shulanx1/dynamic_clamp/README.md

# README #

### Dynamic clamp PCB board and code ###

* Dynamic clamp circuit adapted from Desai NS, Gray R, Johnston D. A Dynamic Clamp on Every Rig. eNeuro. 2017 Oct 23;4(5):ENEURO.0250-17.2017. doi: 10.1523/ENEURO.0250-17.2017. PMID: 29085905; PMCID: PMC5659377.

### Hardware ###

* microcontroller: teensy 3.6

### Files ###

* //dynamic clamp_V1&V2: PCB designs
* //dynamic clamp_V3: PCB design for two channel dynamic clamp
* //dynamic_clamp: arduino code to upload on the microcontroller
* //processing_contrl: GUI based on processing to set parameters on the fly
* //matlab_control: matlab script to sweep the conductance for high conductance state recordings

### Contact ###

* For any questions, contact kjayant@purdue.edu.
