shulanx1/dynamic_clamp/dynamic clamp_pcb - V3/dynamic clamp pcb.sch

## KiCad design dynamic clamp_pcb - V3/dynamic clamp pcb.sch (2023-08-11)

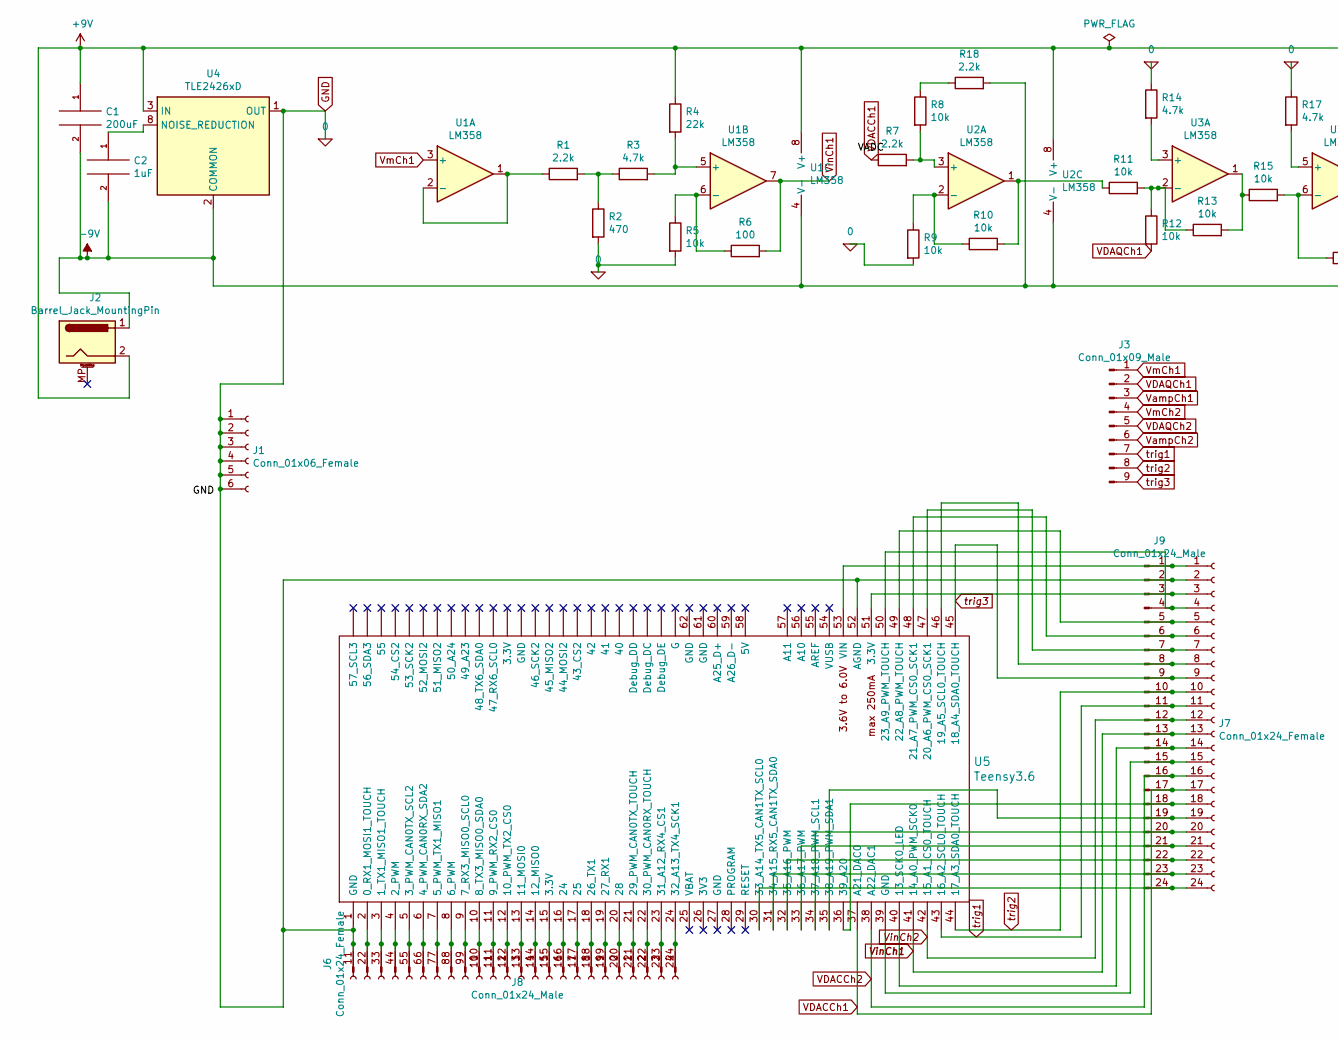
[picture p1: schematic dynamic clamp pcb.sch, part in row 1, column 1]

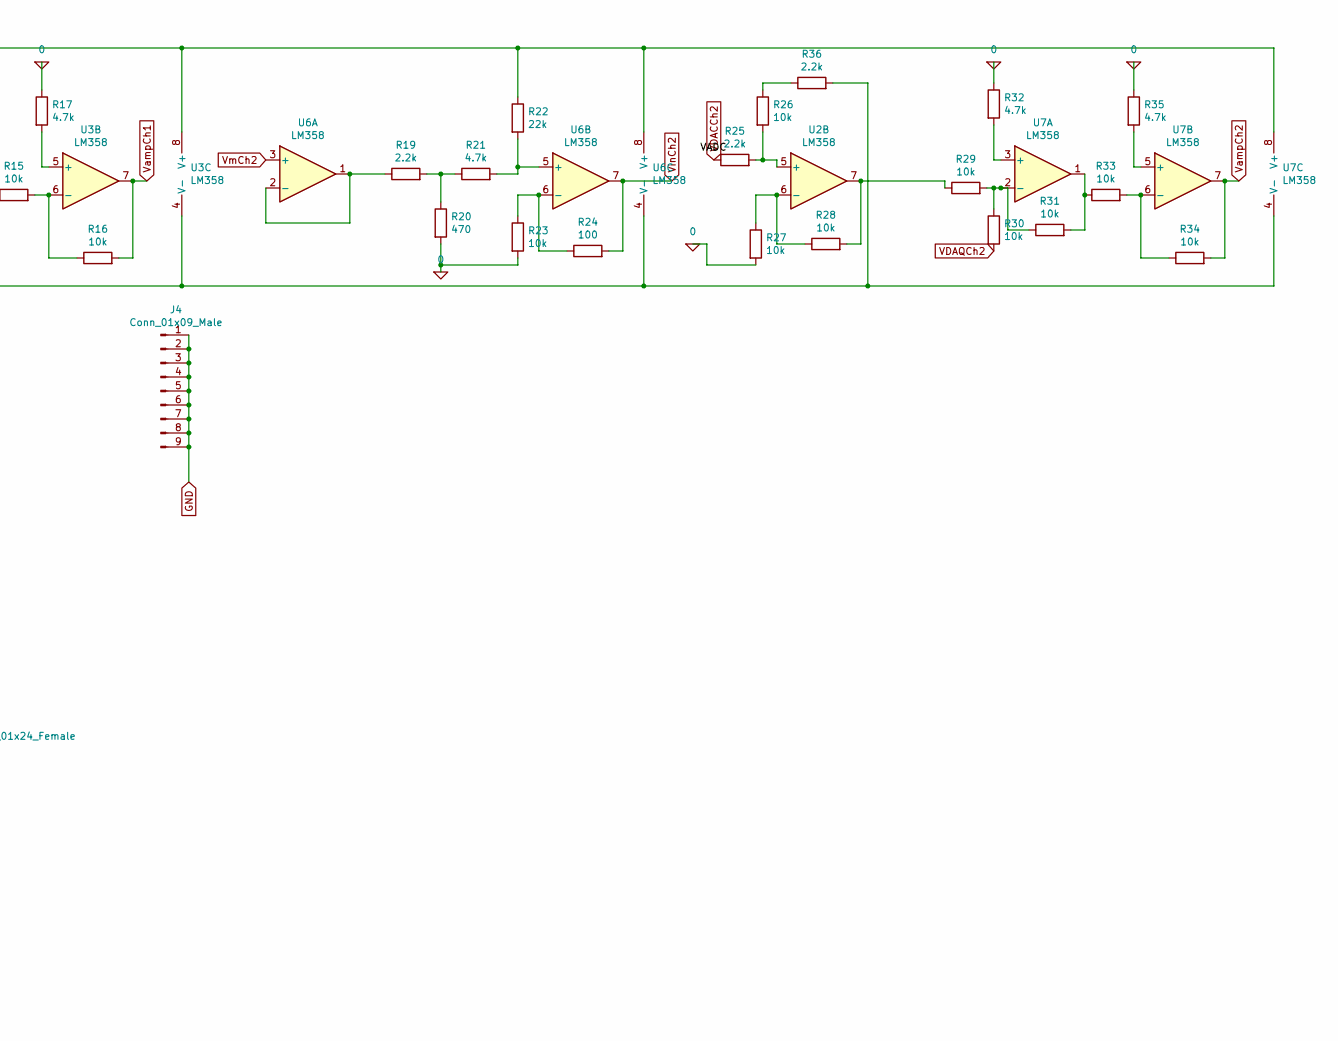
[picture p2: schematic dynamic clamp pcb.sch, part in row 1, column 2]

Parts:
C1: 200uF; CP_Radial_D12.5mm_P5.00mm
C2: 1uF; CP_Radial_D4.0mm_P1.50mm
J1: Conn_01x06_Female; PinHeader_1x06_P2.54mm_Vertical
J2: Barrel_Jack_MountingPin; BarrelJack_CUI_PJ-102AH_Horizontal
J3, J4: Conn_01x09_Male; PinHeader_1x09_P2.54mm_Vertical
J6, J7: Conn_01x24_Female; PinSocket_1x24_P2.54mm_Vertical
J8, J9: Conn_01x24_Male; PinHeader_1x24_P2.54mm_Vertical
R1, R7, R18, R19, R25, R36: 2.2k; R_Axial_DIN0207_L6.3mm_D2.5mm_P7.62mm_Horizontal
R2, R20: 470; R_Axial_DIN0207_L6.3mm_D2.5mm_P7.62mm_Horizontal
R3, R14, R17, R21, R32, R35: 4.7k; R_Axial_DIN0207_L6.3mm_D2.5mm_P7.62mm_Horizontal
R4, R22: 22k; R_Axial_DIN0207_L6.3mm_D2.5mm_P7.62mm_Horizontal
R5, R8, R9, R10, R11, R12, R13, R15, R16, R23, R26, R27, R28, R29, R30, R31, R33, R34: 10k; R_Axial_DIN0207_L6.3mm_D2.5mm_P7.62mm_Horizontal
R6, R24: 100; R_Axial_DIN0207_L6.3mm_D2.5mm_P7.62mm_Horizontal
U1, U2, U3, U6, U7: LM358; DIP-8_W7.62mm
U4: TLE2426xD; DIP-8_W7.62mm
U5: Teensy3.6; Teensy35_36

Connections:
0: J1.1, J1.2, J1.3, J1.4, J1.5, J1.6, J4.1, J4.2, J4.3, J4.4, J4.5, J4.6, J4.7, J4.8, J4.9, J6.1, J7.2, J8.1, J9.2, R2.2, R5.2, R9.2, R14.1, R17.1, R20.2, R23.2, R27.2, R32.1, R35.1, U4.1 (OUT), U5.1 (GND), U5.52 (AGND)
+9V: C1.1, J2.2, R4.1, R22.1, U1.8 (V+), U2.8 (V+), U3.8 (V+), U4.3 (IN), U6.8 (V+), U7.8 (V+)
-9V: C1.2, C2.2, J2.1, R18.2, R36.2, U1.4 (V-), U2.4 (V-), U3.4 (V-), U4.2 (COMMON), U6.4 (V-), U7.4 (V-)
unnamed: C2.1, U4.8 (NOISE_REDUCTION)
unnamed: J6.2, J8.2, U5.2 (0_RX1_MOSI1_TOUCH)
unnamed: J6.3, J8.3, U5.3 (1_TX1_MISO1_TOUCH)
unnamed: J6.4, J8.4, U5.4 (2_PWM)
unnamed: J6.5, J8.5, U5.5 (3_PWM_CAN0TX_SCL2)
unnamed: J6.6, J8.6, U5.6 (4_PWM_CAN0RX_SDA2)
unnamed: J6.7, J8.7, U5.7 (5_PWM_TX1_MISO1)
unnamed: J6.8, J8.8, U5.8 (6_PWM)
unnamed: J6.9, J8.9, U5.9 (7_RX3_MISO0_SCL0)
unnamed: J6.10, J8.10, U5.10 (8_TX3_MISO0_SDA0)
unnamed: J6.11, J8.11, U5.11 (9_PWM_RX2_CS0)
unnamed: J6.12, J8.12, U5.12 (10_PWM_TX2_CS0)
unnamed: J6.13, J8.13, U5.13 (11_MOSI0)
unnamed: J6.14, J8.14, U5.14 (12_MISO0)
unnamed: J6.15, J8.15, U5.15 (3.3V)
unnamed: J6.16, J8.16, U5.16 (24)
unnamed: J6.17, J8.17, U5.17 (25)
unnamed: J6.18, J8.18, U5.18 (26_TX1)
unnamed: J6.19, J8.19, U5.19 (27_RX1)
unnamed: J6.20, J8.20, U5.20 (28)
unnamed: J6.21, J8.21, U5.21 (29_PWM_CAN0TX_TOUCH)
unnamed: J6.22, J8.22, U5.22 (30_PWM_CAN0RX_TOUCH)
unnamed: J6.23, J8.23, U5.23 (31_A12_RX4_CS1)
unnamed: J6.24, J8.24, U5.24 (32_A13_TX4_SCK1)
unnamed: J7.1, J9.1, U5.53 (VIN)
unnamed: J7.3, J9.3, U5.51 (3.3V)
unnamed: J7.4, J9.4, U5.50 (23_A9_PWM_TOUCH)
unnamed: J7.5, J9.5, U5.49 (22_A8_PWM_TOUCH)
unnamed: J7.6, J9.6, U5.48 (21_A7_PWM_CS0_SCK1)
unnamed: J7.7, J9.7, U5.47 (20_A6_PWM_CS0_SCK1)
unnamed: J7.8, J9.8, U5.46 (19_A5_SCL0_TOUCH)
unnamed: J7.14, J9.14, U5.40 (13_SCK0_LED)
unnamed: J7.15, J9.15, U5.39 (GND)
unnamed: J7.18, J9.18, U5.36 (39_A20)
unnamed: J7.19, J9.19, U5.35 (38_A19_PWM_SDA1)
unnamed: J7.20, J9.20, U5.34 (37_A18_PWM_SCL1)
unnamed: J7.21, J9.21, U5.33 (36_A17_PWM)
unnamed: J7.22, J9.22, U5.32 (35_A16_PWM)
unnamed: J7.23, J9.23, U5.31 (34_A15_RX5_CAN1TX_SDA0)
unnamed: J7.24, J9.24, U5.30 (33_A14_TX5_CAN1TX_SCL0)
unnamed: R1.1, U1.1, U1.2 (-)
unnamed: R1.2, R2.1, R3.1
unnamed: R3.2, R4.2, U1.5 (+)
unnamed: R5.1, R6.1, U1.6 (-)
unnamed: R7.2, R8.2, U2.3 (+)
unnamed: R9.1, R10.1, U2.2 (-)
unnamed: R10.2, R11.1, U2.1
unnamed: R11.2, R12.1, R13.1, U3.2 (-)
unnamed: R13.2, R15.1, U3.1
unnamed: R14.2, U3.3 (+)
unnamed: R15.2, R16.1, U3.6 (-)
unnamed: R17.2, U3.5 (+)
unnamed: R8.1, R18.1
unnamed: R19.1, U6.1, U6.2 (-)
unnamed: R19.2, R20.1, R21.1
unnamed: R21.2, R22.2, U6.5 (+)
unnamed: R23.1, R24.1, U6.6 (-)
unnamed: R25.2, R26.2, U2.5 (+)
unnamed: R26.1, R36.1
unnamed: R27.1, R28.1, U2.6 (-)
unnamed: R28.2, R29.1, U2.7
unnamed: R29.2, R30.1, R31.1, U7.2 (-)
unnamed: R31.2, R33.1, U7.1
unnamed: R32.2, U7.3 (+)
unnamed: R33.2, R34.1, U7.6 (-)
unnamed: R35.2, U7.5 (+)
VDACCh1: J7.17, J9.17, R7.1, U5.37 (A21_DAC0)
VDACCh2: J7.16, J9.16, R25.1, U5.38 (A22_DAC1)
VDAQCh1: J3.2, R12.2
VDAQCh2: J3.5, R30.2
VampCh1: J3.3, R16.2, U3.7
VampCh2: J3.6, R34.2, U7.7
VinCh1: J7.13, J9.13, R6.2, U1.7, U5.41 (14_A0_PWM_SCK0)
VinCh2: J7.12, J9.12, R24.2, U5.42 (15_A1_CS0_TOUCH), U6.7
VmCh1: J3.1, U1.3 (+)
VmCh2: J3.4, U6.3 (+)
trig1: J3.7, J7.11, J9.11, U5.43 (16_A2_SCL0_TOUCH)
trig2: J3.8, J7.10, J9.10, U5.44 (17_A3_SDA0_TOUCH)
trig3: J3.9, J7.9, J9.9, U5.45 (18_A4_SDA0_TOUCH)
