shulanx1/dynamic_clamp/dynamic_clamp/dynamic_clamp.ino

// teensy 3.6 sketch to implement dynamic clamp
//
// The sketch includes a main file (this one) and other files (which appear as tabs) that define the conductances.
// The main file is organized like this:
//      (i)   global variables are declared first. inputScaling and outputScaling are properties of the patch
//            clamp amplifier (a user should specify these for their own amplifier). The calibration parameters
//            are properties of the components on the breadboard (and are usually set by the calibration sketch).
//            The dynamic clamp parameters will be specified by the Processing GUI or by some other program (Matlab,
//            Igor Pro, Python, etc.) the user chooses. dt and t0 are used to keep time. Hardware connections
//            are chosen by the user.
//      (ii)  setup(). Every Arduino-like sketch includes a setup() function which is run when the sketch is 
//            uploaded to the microcontroller. Serial communication is established with the host computer (for use
//            by Processing, Matlab, Igor Pro, Python, or whatever). 12-bit resolution is specified for analog
//            read and write. Any numbers that should be pre-calculated and stored in global variables (e.g.,
//            the lookup table numbers for sodium activation/inactivation) are calculated by calling the function
//            (in one of the tabbed files) that defines them. The trigger pin for EPSCs is established.
//      (iii) loop(). The loop() function is run continuously (i.e., once per time step). The first part checks
//            whether the microcontroller has received any serial communication instructing it to change the
//            dynamic clamp parameters (e.g., shunt conductance or OU excitatory diffusion constant). The second 
//            part reads the signal from the patch clamp amplifier's output (which has already been buffered,
//            shifted, and scaled by the breadboard electronics), converts this signal into membrane potential v
//            in millivolts (using the calibration parameters), and sends v out to the functions (in the tabbed files)
//            that calculate the dynamic clamp current in picoamps for the various conductances. All of these currents
//            are summed. The third and last part converts the summed current (in picoamps) into the output to 
//            be sent (0-4095) from the analog output pin. This output will be shifted, scaled, and added to the 
//            DAQ board's current clamp command by breadboard electronics. The total signal will then be fed to 
//            the patch clamp amplifier's command input. 
// Each dynamic clamp conductance is defined by one of the tabbed files. These files can contain multiple functions
//            and their own global variables (accessible to the functions of the tabbed file). For example, the file Sodium
//            contains declarations for the activation/inactivation lookup variables, a function that calculates the activation
//            and inactivation numbers for a range of membrane potentials and stores them in the lookup table variables,
//            and the function called at every time step to calculate the sodium current to be injected. 
//
// Last revised 08/25/17, 6:15 pm


#include <math.h>

// Scaling for the patch clamp amplifier
float inputScaling = 10.0;                 // number of millivolts sent out by amplifier for each millivolt of membrane potential
                                           // e.g., with a scaling of 50, if the membrane potential is -65 mV, the amplifier outputs -3.25 V
float outputScaling = 400.0;               // number of picoamps injected for every volt at the amplifier's command input
                                           // e.g., if the DAC or the Teensy outputs -0.5 V, this is interpreted as -200 pA by the amplifier
                                           // when the scaling is 400


// Calibrating the input/output numbers given the resistor values and power supply values of the breadboard
// N.B.: these parameters (numerators) are properties of the components on the breadboard;
// they are independent of the amplifier and DAQ board
const float inputSlope_CH1 = 0.55988;  //theoretical  0.5499, 2%error
const float inputIntercept_CH1 = -1188.9;    //theoretical    -1092.2, 
const float outputSlope_CH1 = 1.86535;       //theoretical 1.8315
const float outputIntercept_CH1 = 2064.2;    //theoretical 2014.7

// Calibrating the input/output numbers given the resistor values and power supply values of the breadboard
// N.B.: these parameters (numerators) are properties of the components on the breadboard;
// they are independent of the amplifier and DAQ board
const float inputSlope_CH2 = 0.55988;//theoretical  0.5499, 2%error
const float inputIntercept_CH2 = -1188.9;//theoretical    -1092.2, 
const float outputSlope_CH2 = 1.86535; //theoretical 1.8315
const float outputIntercept_CH2 = 2064.2;  //theoretical 2014.7

// Conductance parameters are sent by the host computer over the USB port
const int nPars = 29;              // number of adjustable parameters
float gShunt_CH1 = 0.0;               // nS, shunting conductance
float gNa_CH1 = 0.0;                  // nS, maximal fast, transient sodium conductance
float OU1_mean_CH1 = 0.0;             // nS, excitatory Ornstein-Uhlenbeck (OU) mean conductance
float OU1_D_CH1 = 0.0;                // nS^2/msec, excitatory OU diffusion constant
float OU2_mean_CH1 = 0.0;             // nS, inhibitory OU mean conductance
float OU2_D_CH1 = 0.0;                // nS^2/msec, inhibitory OU diffusion constant
float OU1_2_mean_CH1 = 0.0;             // nS, excitatory Ornstein-Uhlenbeck (OU) mean conductance
float OU1_2_D_CH1 = 0.0;                // nS^2/msec, excitatory OU diffusion constant
float gEPSC_CH1 = 0.0;                // nS, maximal conductance of EPSCs
float fPoisson_CH1 = 0.0;                // Hz, frequency of poisson train of EPSCs
//float fUncaging = 0.0;                // Hz, frequency of poisson train of EPSCs
float gNap_CH1 = 0.0;                 //nS, conductance of Nap to be canceled 
float gNap_E2_CH1 = 0.0;                 //nS, Nap with slow inactivation gate and mtau varies with time
float gCal_CH1 = 0.0;                 //nS, low threshold Ca channel
float gCah_CH1 = 0.0;                 //nS, high threshold Ca channel
float gH_CH1 = 0.0;                   // nS, maximal H (HCN) conductance

float gShunt_CH2 = 0.0;               // nS, shunting conductance
float gNa_CH2 = 0.0;                  // nS, maximal fast, transient sodium conductance
float OU1_mean_CH2 = 0.0;             // nS, excitatory Ornstein-Uhlenbeck (OU) mean conductance
float OU1_D_CH2 = 0.0;                // nS^2/msec, excitatory OU diffusion constant
float OU2_mean_CH2 = 0.0;             // nS, inhibitory OU mean conductance
float OU2_D_CH2 = 0.0;                // nS^2/msec, inhibitory OU diffusion constant
float OU1_2_mean_CH2 = 0.0;             // nS, excitatory Ornstein-Uhlenbeck (OU) mean conductance
float OU1_2_D_CH2 = 0.0;                // nS^2/msec, excitatory OU diffusion constant
float gEPSC_CH2 = 0.0;                // nS, maximal conductance of EPSCs
float fPoisson_CH2 = 0.0;                // Hz, frequency of poisson train of EPSCs
//float fUncaging = 0.0;                // Hz, frequency of poisson train of EPSCs
float gNap_CH2 = 0.0;                 //nS, conductance of Nap to be canceled 
float gNap_E2_CH2 = 0.0;                 //nS, Nap with slow inactivation gate and mtau varies with time
float gCal_CH2 = 0.0;                 //nS, low threshold Ca channel
float gCah_CH2 = 0.0;                 //nS, high threshold Ca channel
float gH_CH2 = 0.0;                   // nS, maximal H (HCN) conductance

float trig = 0.0;                 //output trigger, to trigger the start of ephys recording
float y = 0.0;                    // random variable of bernoulli trials for poisson train




// Common global variables
float dt = 0.01;                  // msec, the time step -- on a Teensy/Arduino dt will be variable
elapsedMicros t0;                 // microsec, t0 is used to calculate dt on every iteration
elapsedMillis epscTime_CH1;           // msec, time since last EPSC was triggered
elapsedMillis epscTime_CH2;
elapsedMillis uncagingTime;           // msec, time since last EPSC was triggered

// Hardware connections
const int analogInPin_CH1 = 0;        // ADC pin used to read membrane potential
const int analogOutPin_CH1 = A21;     // DAC pin used to output current
const int analogInPin_CH2 = 1;        // ADC pin used to read membrane potential
const int analogOutPin_CH2 = A22;     // DAC pin used to output current
const int epscTriggerPin = A2;     // pin used to trigger EPSC train 
const int uncagingTriggerPin = A3;     // pin used to uncaging train
const int startTriggerPin = A4; // pin used to trigger start of uncaging 

const int uniformPoolSize = 100;
float uniformRandomNumbers[uniformPoolSize] = {0.0};
void GenerateUniformNumbers() {
  for (int x=0; x<uniformPoolSize; x++){
    uniformRandomNumbers[x] = random(1001)/1000.0;
}
}


void setup() {      
  Serial.begin(115200);
  analogWriteResolution(12);
  analogReadResolution(12);
  while (Serial.available()>0) {                // make sure serial buffer is clear  
    char foo = Serial.read();
  }
  GenerateGaussianNumbers();                    // generate a pool of Gaussian numbers for use by the OU processes  
  //GenerateSodiumLUT();                          // generate sodium activation/inactivation lookup table
  GenerateInapLUT();                          // generate inap activation lookup table
  GenerateHcnLUT();                             // generate HCN activation lookup table
  GenerateNapLUT();                          // generate Nap_E2 activation lookup table
  GenerateCahLUT();                             // generate Cah activation lookup table    
  GenerateCalLUT();                             // generate Cal activation lookup table    
  GenerateUniformNumbers();

  
  

  
  // pin mode
  pinMode(epscTriggerPin,INPUT);                // define the pin that receives a trigger when an EPSC should be injected
  pinMode(uncagingTriggerPin,OUTPUT); 
  pinMode(startTriggerPin,OUTPUT);
}




void loop() {

  // Part 1:    Serial Communication & Parameter Setting
  // The host computer tells the Teensy when the dynamic clamp parameters should change.
  // To do this, it sends 4-byte-long numbers, one for each parameter. So if there are 
  // 8 adjustable parameters, it will send 32 bytes. At present, the adjustable parameters
  // are the shunt conductance (nS), maximal HCN conductance (nS), maximal Na conductance (nS),
  // excitatory OU conductance (OU1) mean (nS), excitatory OU conductance diffusion constant (nS^2/ms),
  // inhibitory OU conductance (OU2) mean (nS), inhibitory OU conductance (OU2) diffusion
  // constant (nS^2/ms), and maximal EPSC conductance (nS).
  union {
    byte asByte[4];
    float asFloat;
  } data1;
  static float dataTemp[nPars] = {0.0};
  static byte parNo = 0;
  if (Serial.available()>3) {
    for (int x=0; x<4; x++) data1.asByte[x] = Serial.read();
    dataTemp[parNo] = data1.asFloat;
    parNo++;
    if (parNo==nPars) {
      gShunt_CH1 = dataTemp[0];
      OU1_mean_CH1 = dataTemp[1];
      OU1_D_CH1 = dataTemp[2];
      OU2_mean_CH1 = dataTemp[3];
      OU2_D_CH1 = dataTemp[4];
      OU1_2_mean_CH1 = dataTemp[5];
      OU1_2_D_CH1 = dataTemp[6];
      gEPSC_CH1 = dataTemp[7];
      fPoisson_CH1 = dataTemp[8];
      gNap_CH1 = dataTemp[9];
      gNap_E2_CH1 = dataTemp[10];
      gCal_CH1 = dataTemp[11];
      gCah_CH1 = dataTemp[12];
      gH_CH1 = dataTemp[13];

      gShunt_CH2 = dataTemp[14];
      OU1_mean_CH2 = dataTemp[15];
      OU1_D_CH2 = dataTemp[16];
      OU2_mean_CH2 = dataTemp[17];
      OU2_D_CH2 = dataTemp[18];
      OU1_2_mean_CH2 = dataTemp[19];
      OU1_2_D_CH2 = dataTemp[20];
      gEPSC_CH2 = dataTemp[21];
      fPoisson_CH2 = dataTemp[22];
      gNap_CH2 = dataTemp[23];
      gNap_E2_CH2 = dataTemp[24];
      gCal_CH2 = dataTemp[25];
      gCah_CH2 = dataTemp[26];
      gH_CH2 = dataTemp[27];
      trig = dataTemp[28];
      parNo = 0;
    }
  }



  // Part 2:    Read membrane potential & calculate dynamic clamp currents 
  float v_CH1 = inputSlope_CH1 * analogRead(analogInPin_CH1) + inputIntercept_CH1;    // mV, given amplifier settings 
  float injectionCurrent_CH1 = 0.0;                                       // pA

  float v_CH2 = inputSlope_CH2 * analogRead(analogInPin_CH2) + inputIntercept_CH2;    // mV, given amplifier settings 
  float injectionCurrent_CH2 = 0.0;                                       // pA
  dt = 0.001*(float)t0;                                               // msec, time step
  t0 = 0;                                                             // set elapsed time back to zero

  
//CH1  
  if (gShunt_CH1>0) {
    injectionCurrent_CH1 += Shunting_CH1(v_CH1);
  }
  if (gH_CH1 != 0.0) {
    injectionCurrent_CH1 += HCN_CH1(v_CH1);
  }
  if (gNap_CH1!=0.0) {
    injectionCurrent_CH1 += inap_CH1(v_CH1);
  }  
  if (gNap_E2_CH1 != 0.0) {
    injectionCurrent_CH1 += nap_E2_CH1(v_CH1);
  }
  if (gCal_CH1 != 0.0) {
    injectionCurrent_CH1 += cal_CH1(v_CH1);
  }
  if (gCah_CH1 != 0.0) {
    injectionCurrent_CH1 += cah_CH1(v_CH1);
  }
  if (OU1_2_mean_CH1 ==0 && (OU1_mean_CH1>0 || OU2_mean_CH1>0) ) {
    injectionCurrent_CH1 += OrnsteinUhlenbeck_CH1(v_CH1);
  }
  if (OU1_2_mean_CH1 >0 && (OU1_mean_CH1>0 || OU2_mean_CH1>0) ) {
    injectionCurrent_CH1 += OrnsteinUhlenbeck_wNMDA_CH1(v_CH1);
  }
  if (gEPSC_CH1>0 && fPoisson_CH1 == 0) {
    if ((digitalReadFast(epscTriggerPin)==HIGH)&&(epscTime_CH1>2)) {        // poll epscTriggerPin to see if a trigger has arrived
      UpdateEpscTrain_CH1();
      epscTime_CH1 = 0;
    }
    injectionCurrent_CH1 += EPSC_CH1(v_CH1);
  }
  if (gEPSC_CH1>0 && fPoisson_CH1>0) {
    //y = uniformRandomNumbers[random(uniformPoolSize)];
    y = random(1001)/1000.0;
    if ((y<=dt/1000.0*fPoisson_CH1)&&(epscTime_CH1>5)) {        // poll epscTriggerPin to see if a trigger has arrived
      UpdateEpscTrain_CH1();
      epscTime_CH1 = 0;
    }
    injectionCurrent_CH1 += EPSC_CH1(v_CH1);
  }
  
// CH2
  if (gShunt_CH2>0) {
    injectionCurrent_CH2 += Shunting_CH2(v_CH2);
  }
  if (gH_CH2 != 0.0) {
    injectionCurrent_CH2 += HCN_CH2(v_CH2);
  }
  if (gNap_CH2!=0.0) {
    injectionCurrent_CH2 += inap_CH2(v_CH2);
  }  
  if (gNap_E2_CH2 != 0.0) {
    injectionCurrent_CH2 += nap_E2_CH2(v_CH2);
  }
  if (gCal_CH2 != 0.0) {
    injectionCurrent_CH2 += cal_CH2(v_CH2);
  }
  if (gCah_CH2 != 0.0) {
    injectionCurrent_CH2 += cah_CH2(v_CH2);
  }
  if (OU1_2_mean_CH2 ==0 && (OU1_mean_CH2>0 || OU2_mean_CH2>0) ) {
    injectionCurrent_CH2 += OrnsteinUhlenbeck_CH2(v_CH2);
  }
  if (OU1_2_mean_CH2 >0 && (OU1_mean_CH2>0 || OU2_mean_CH2>0) ) {
    injectionCurrent_CH2 += OrnsteinUhlenbeck_wNMDA_CH2(v_CH2);
  }
  if (gEPSC_CH2>0 && fPoisson_CH2 == 0) {
    if ((digitalReadFast(epscTriggerPin)==HIGH)&&(epscTime_CH2>2)) {        // poll epscTriggerPin to see if a trigger has arrived
      UpdateEpscTrain_CH2();
      epscTime_CH2 = 0;
    }
    injectionCurrent_CH2 += EPSC_CH2(v_CH2);
  }
  if (gEPSC_CH2>0 && fPoisson_CH2>0) {
    //y = uniformRandomNumbers[random(uniformPoolSize)];
    y = random(1001)/1000.0;
    if ((y<=dt/1000.0*fPoisson_CH2)&&(epscTime_CH2>5)) {        // poll epscTriggerPin to see if a trigger has arrived
      UpdateEpscTrain_CH2();
      epscTime_CH2 = 0;
    }
    injectionCurrent_CH2 += EPSC_CH2(v_CH2);
  }
  
  if (trig>0) {
    trig_out();
    trig = 0;
  }

 
  
  // Part 3:      Send out the calculated dynamic clamp current
  injectionCurrent_CH1 = outputSlope_CH1 * injectionCurrent_CH1 + outputIntercept_CH1;  // pA converted into analog output integers
  int outputSignal_CH1 = constrain((int)injectionCurrent_CH1,0,4095);           // make sure the output is an integer between 0 and 4095 (12 bits)
  analogWrite(analogOutPin_CH1,outputSignal_CH1);                               // send the output to the patch clamp or summing amplifier

  injectionCurrent_CH2 = outputSlope_CH2 * injectionCurrent_CH2 + outputIntercept_CH2;  // pA converted into analog output integers
  int outputSignal_CH2 = constrain((int)injectionCurrent_CH2,0,4095);           // make sure the output is an integer between 0 and 4095 (12 bits)
  analogWrite(analogOutPin_CH2,outputSignal_CH2);                               // send the output to the patch clamp or summing amplifier
}
