shulanx1/dynamic_clamp/dynamic_clamp/Sodium.ino

// A fast, transient Na+ conductance using the Hodgkin-Huxley formalism.
// For speed, the parameters alphaM, betaM, alphaH, and betaH are pre-calculated
// and put in lookup tables stored as global variables.

// Declare the lookup table variables
float alphaM[1501] = {0.0};                          // Pre-calculate activation and inactivation parameters 
float betaM[1501] = {0.0};                           // for sodium currents: Vm from -100 mV to +50 mV in 
float alphaH[1501] = {0.0};                          // steps of 0.1 mV
float betaH[1501] = {0.0};

// Generate the lookup tables
void GenerateSodiumLUT() {
  float v;
  for (int x=0; x<1501; x++) {
    v = (float)x/10 - 100.0;                        // We use membrane potentials between -100 mV and +50 mV
    if (x==600) {                                   // The if-else statement makes sure alphaM stays finite at v = -40 mV.
      alphaM[x] = 1.0;
    } else {
      alphaM[x] = 0.1 * (-(v+40.0)) / ( expf( -(v+40.0)/10 ) - 1 );
    }
    betaM[x] = 4.0 * expf(-(v+65)/18);
    alphaH[x] = 0.07 * expf(-(v+65)/20);
    betaH[x] = 1 / ( expf(-(v+35)/10 ) + 1); 
  }
}

// At every time step, calculate the sodium current in the Hodgkin-Huxley manner
float Sodium_CH1(float v) {
  static float mNaVar_CH1 = 0.0;    // activation gate
  static float hNaVar_CH1 = 1.0;    // inactivation gate
  float v10 = v*10.0;
  int vIdx = (int)v10 + 1000;
  vIdx = constrain(vIdx,0,1500);
  mNaVar_CH1 = mNaVar_CH1 + dt * ( alphaM[vIdx]*(1-mNaVar_CH1) - betaM[vIdx]*mNaVar_CH1 );
  if (mNaVar_CH1 < 0.0) mNaVar_CH1 = 0.0;
  hNaVar_CH1 = hNaVar_CH1 + dt * ( alphaH[vIdx]*(1-hNaVar_CH1) - betaH[vIdx]*hNaVar_CH1 );
  if (hNaVar_CH1 < 0.0) hNaVar_CH1 = 0.0;
  float current1 = -gNa_CH1 * mNaVar_CH1 * mNaVar_CH1 * mNaVar_CH1 * hNaVar_CH1 * (v - 50);  // ENa = +50 mV
  return current1;
}

float Sodium_CH2(float v) {
  static float mNaVar_CH2 = 0.0;    // activation gate
  static float hNaVar_CH2 = 1.0;    // inactivation gate
  float v10 = v*10.0;
  int vIdx = (int)v10 + 1000;
  vIdx = constrain(vIdx,0,1500);
  mNaVar_CH2 = mNaVar_CH2 + dt * ( alphaM[vIdx]*(1-mNaVar_CH2) - betaM[vIdx]*mNaVar_CH2 );
  if (mNaVar_CH2 < 0.0) mNaVar_CH2 = 0.0;
  hNaVar_CH2 = hNaVar_CH2 + dt * ( alphaH[vIdx]*(1-hNaVar_CH2) - betaH[vIdx]*hNaVar_CH2 );
  if (hNaVar_CH2 < 0.0) hNaVar_CH2 = 0.0;
  float current1 = -gNa_CH2 * mNaVar_CH2 * mNaVar_CH2 * mNaVar_CH2 * hNaVar_CH2 * (v - 50);  // ENa = +50 mV
  return current1;
}
